jzj1993/Frequency-Meter-Verilog/其他文件/器件清单.xlsx

器件 | 数量(可多买几个备用)
555定时器 | 1
0.01uF电容(瓷片/电解均可) | 1
0.1uF电容(瓷片/电解均可) | 1
10kΩ电位器(10圈精密可调电位器) | 1
4位共阳数码管 | 1
9012三极管 | 4
330Ω电阻(接数码管段选端， 用于保护CPLD引脚) | 8
万用焊板(如果直接用 实验板插接，可不使用) | 2
