jzj1993/Frequency-Meter-Verilog/(list of files, drawings)

Other design files:
其他文件/555波形发生器Multisim仿真.ms12
其他文件/数码管电路 Altium Designer工程/PCB_Project1.PrjPCB
其他文件/数码管电路 Altium Designer工程/Sheet1.SchDoc
